peterotte/HPCSlowControl/README.md

# HPCSlowControl
HPC SlowControl for Arduino

This is an sample implementation for the Sensor Aggregation Unit to read out connected OneWire and I2C sensors. 

Arduino Folder
  * Eagle Files (and converted into PDF)
  * Schematics housing as PDF
  * Bootloader with settings fpr ATMEL Mega 328PB
