peterotte/HPCSlowControl/arduinofiles/HIM-Otte-server-slow-control-V1-3a-brd.pdf

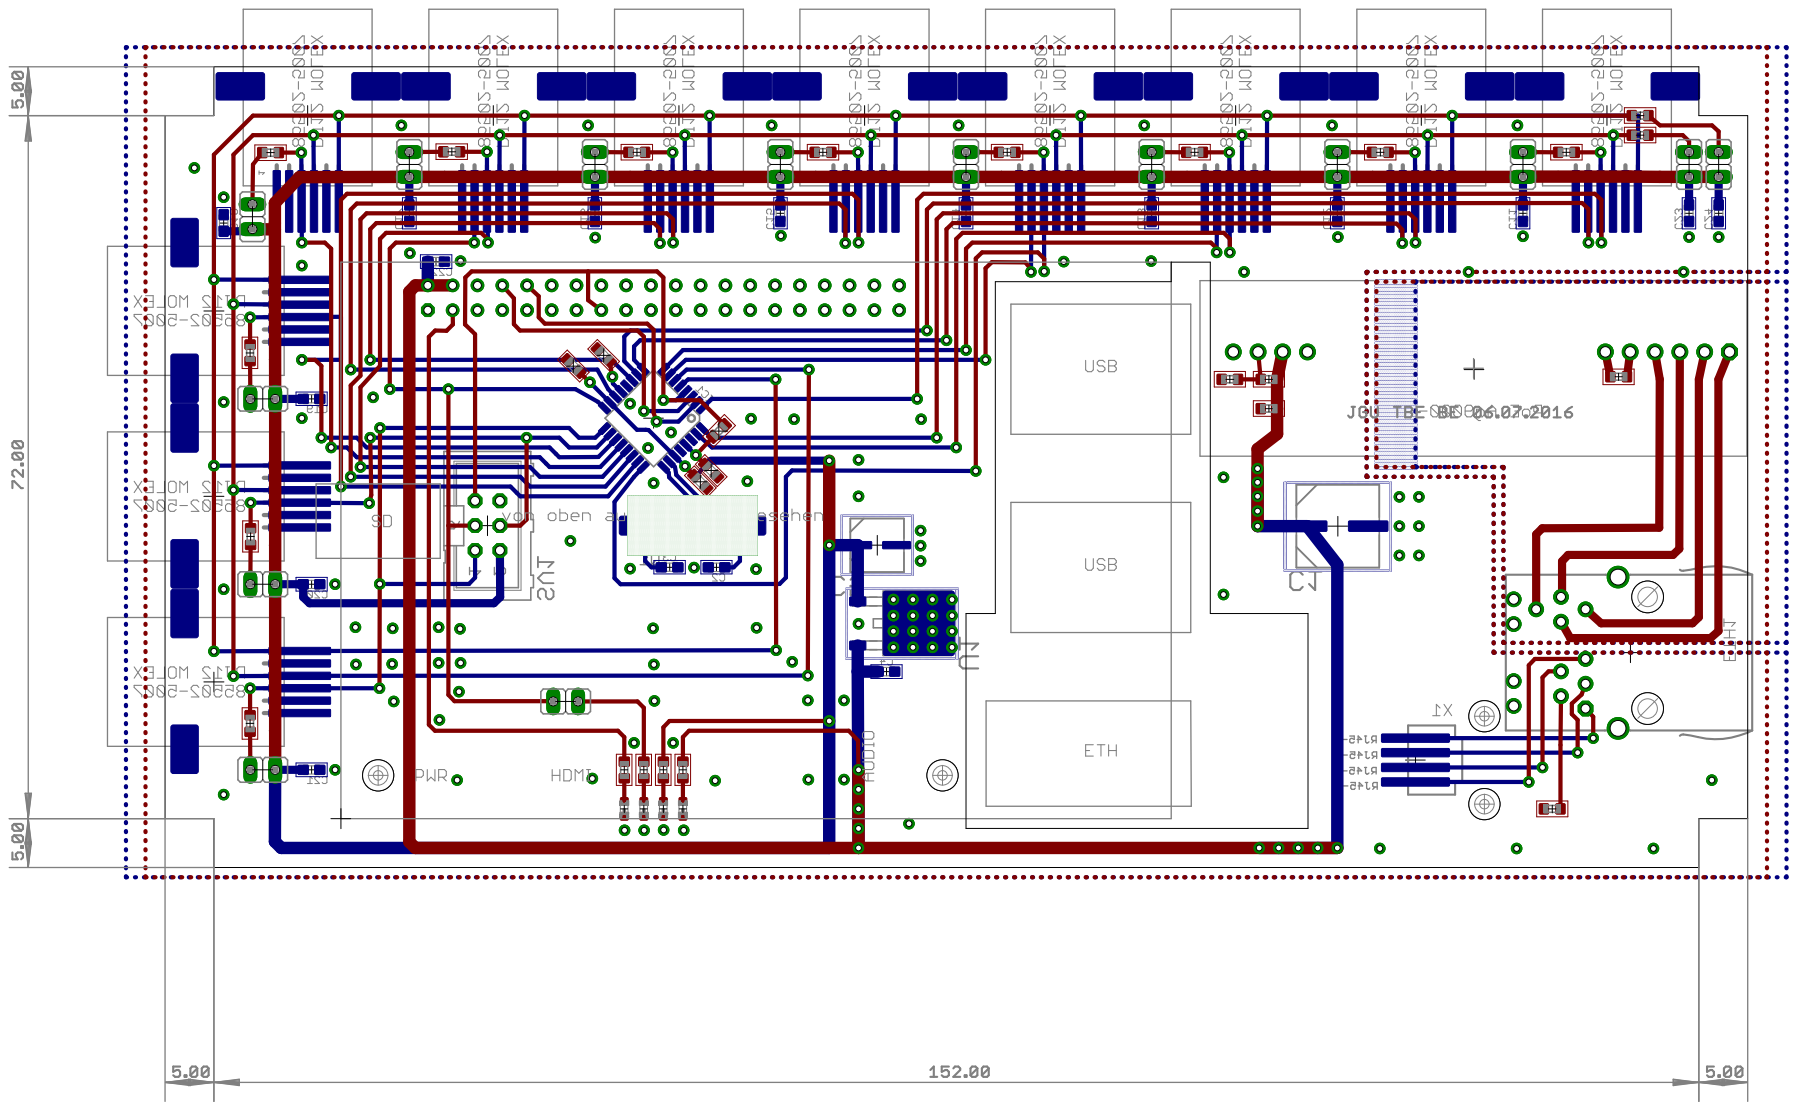
[picture p1: page 1]
