peterotte/HPCSlowControl/arduinofiles/HIM-Otte-server-slow-control-V1-3a-sch.pdf

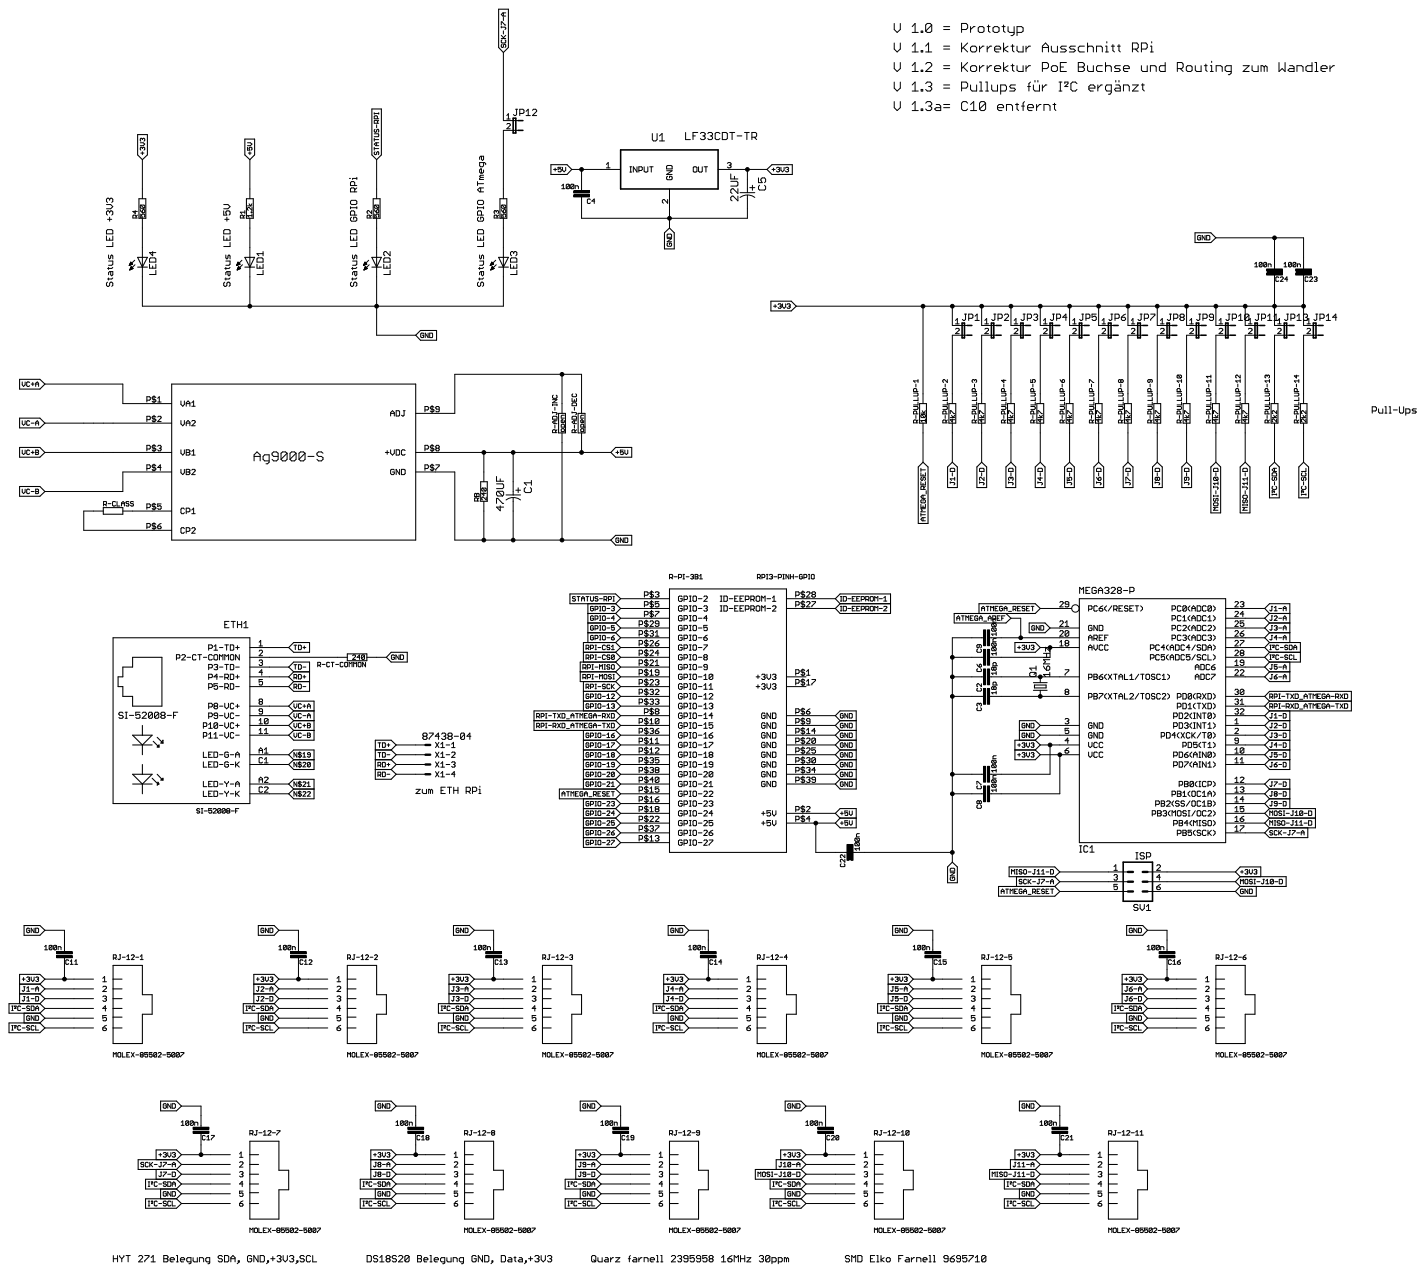
[picture p2: page 1]
