peterotte/HPCSlowControl/arduinofiles/HIM-Otte-server-slow-control-V1-2_Gehaeuse-lange-Seite.pdf

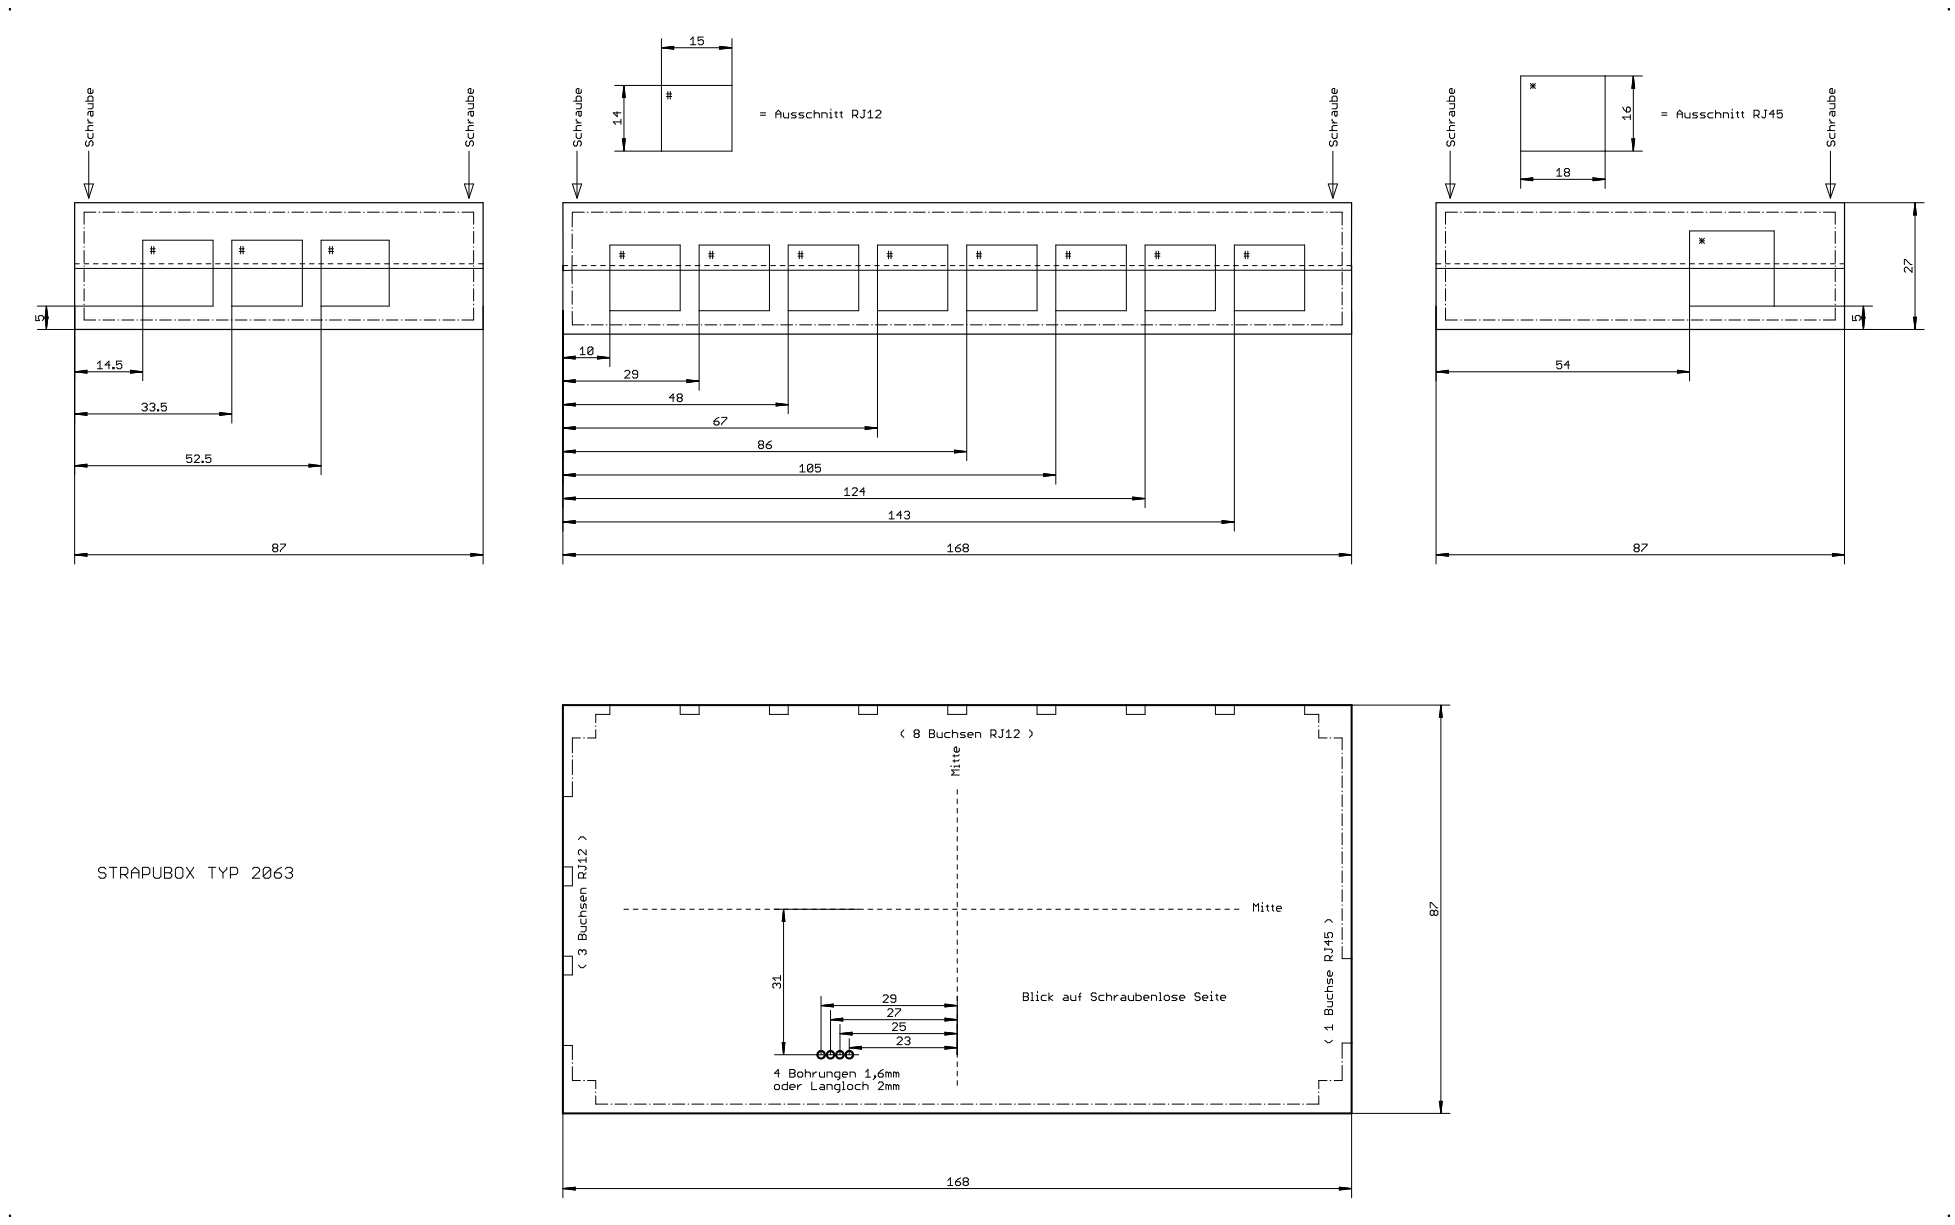
[picture p3: page 1]
