peterotte/HPCSlowControl/arduinofiles/HIM-Otte-server-slow-control-V1-3a.brd

## EAGLE design arduinofiles/HIM-Otte-server-slow-control-V1-3a.brd (2017-09-28)

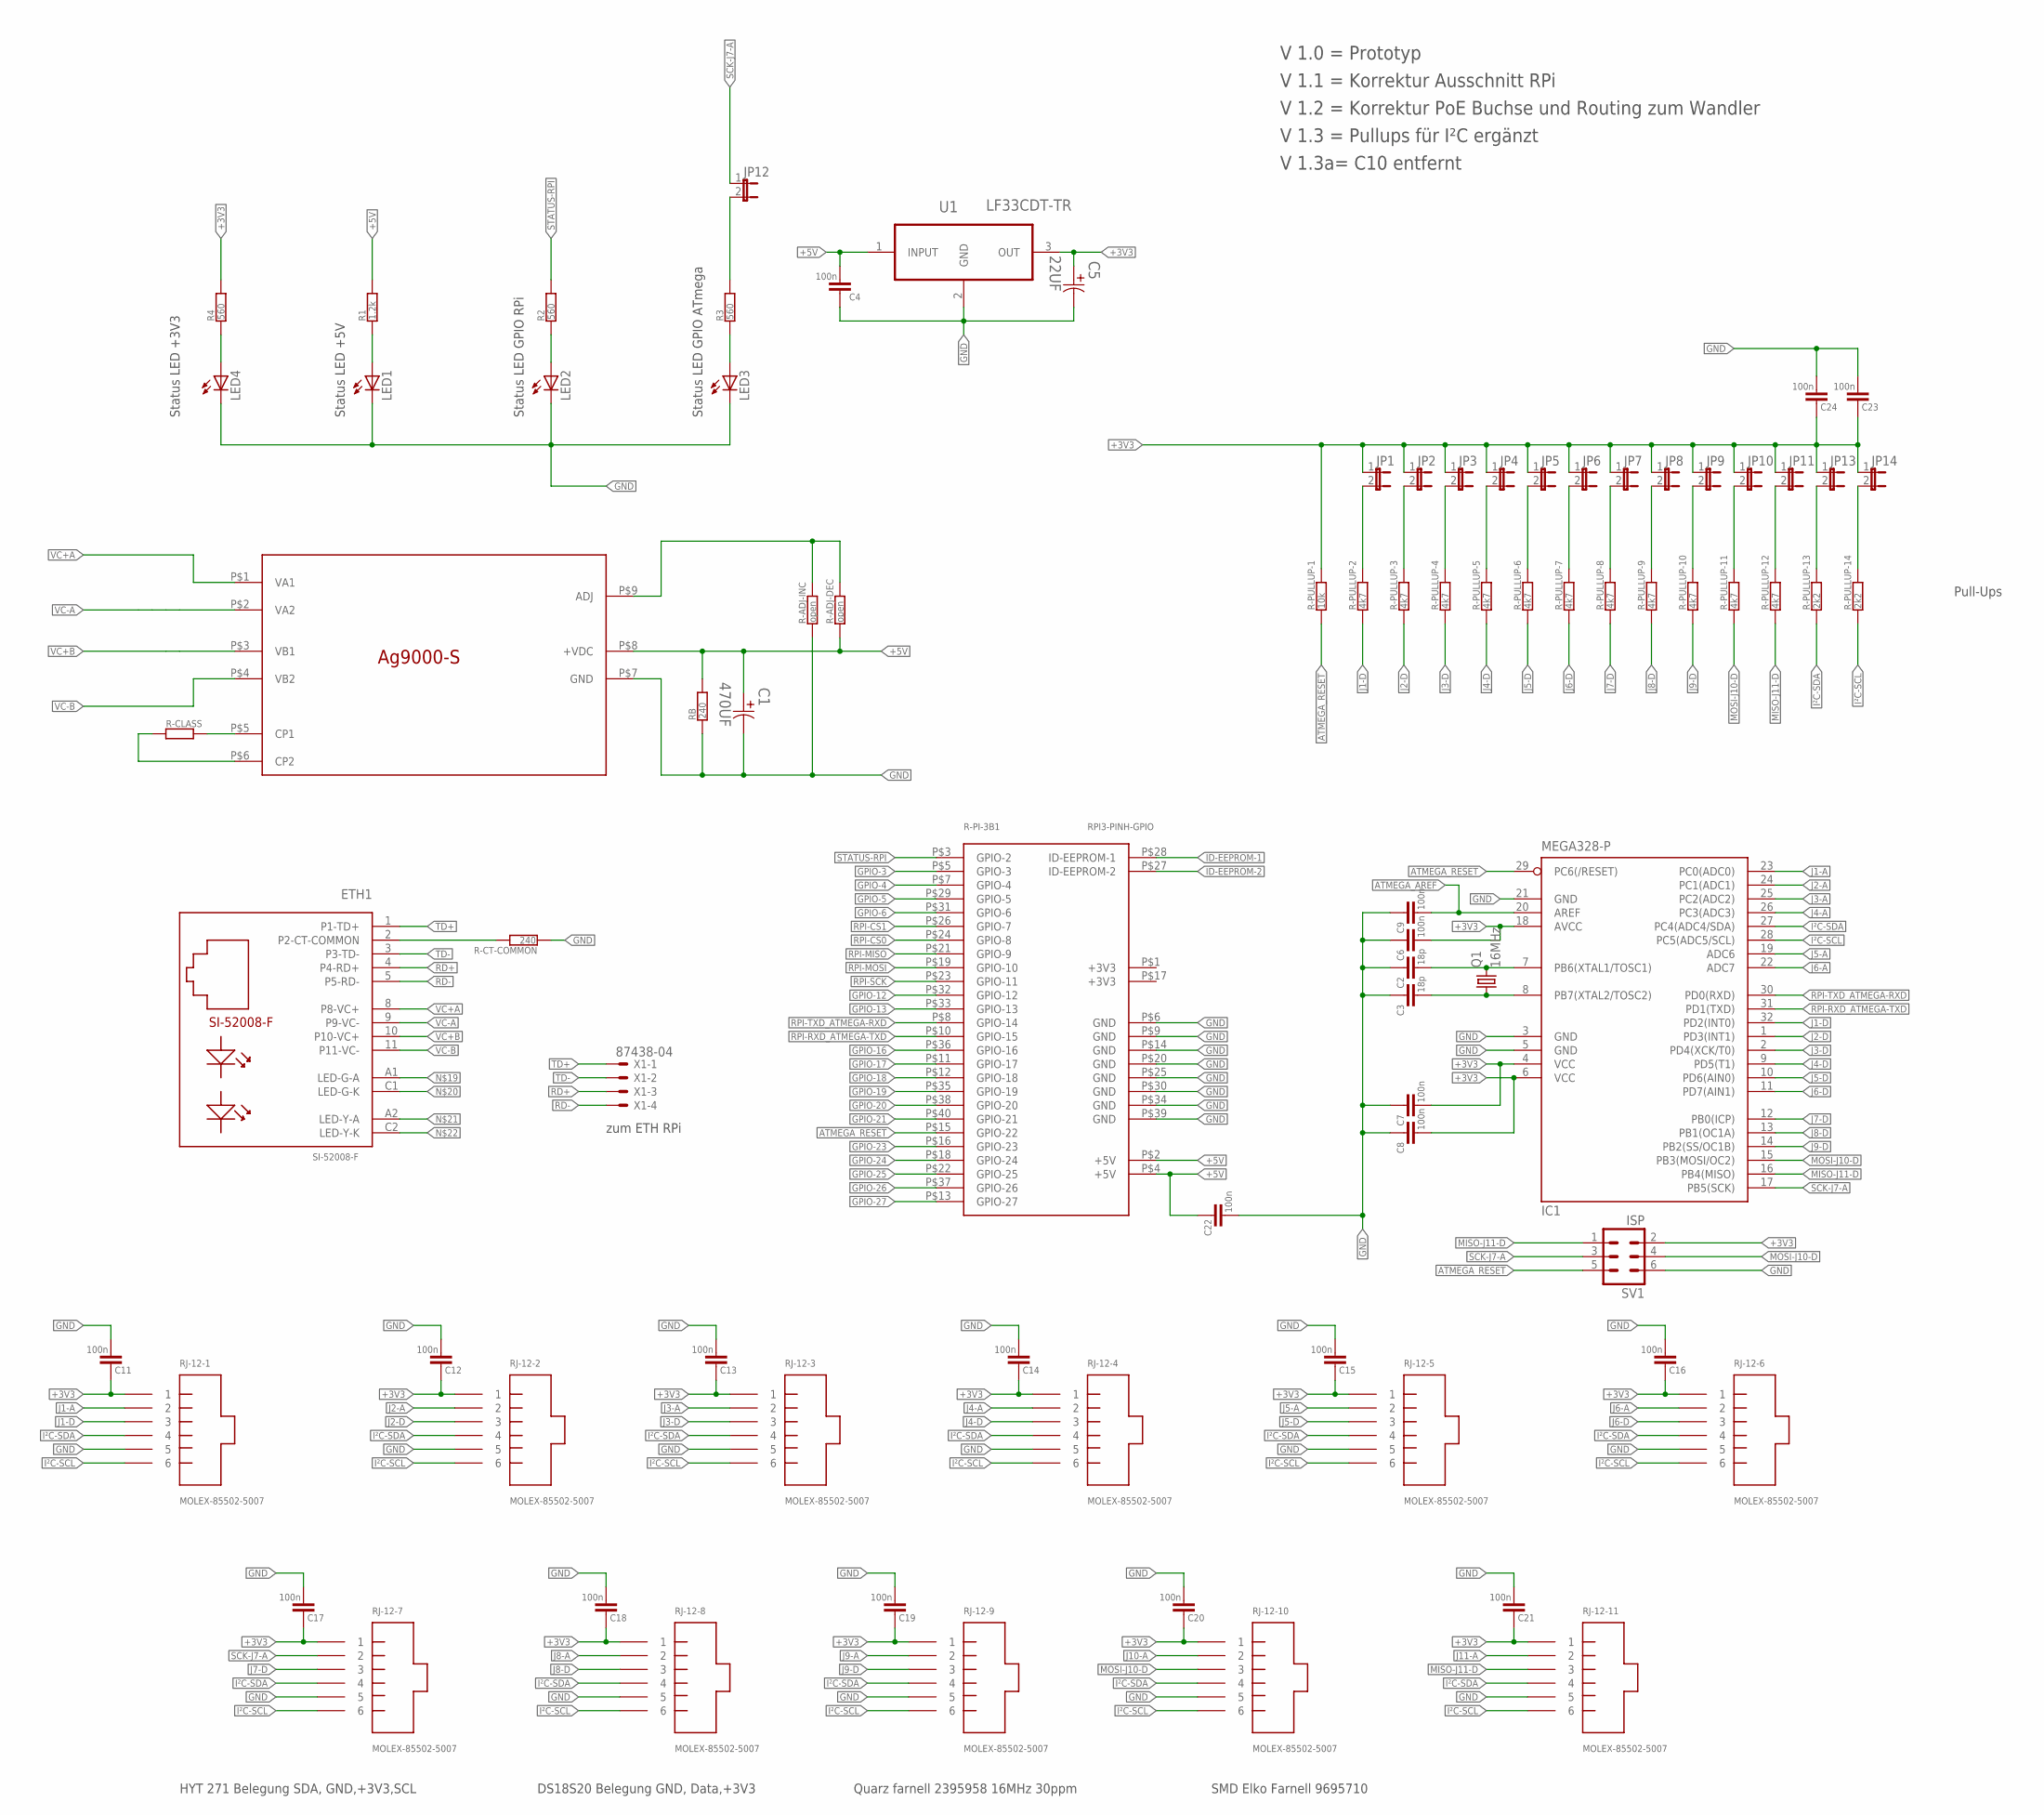
[picture p4: schematic HIM-Otte-server-slow-control-V1-3a.sch]

Parts:
C1: 470UF; CAPAE830X1050N
C2, C3: 18p; C0603
C4, C6, C7, C8, C9, C11, C12, C13, C14, C15, C16, C17, C18, C19, C20, C21, C22, C23, C24: 100n; C0603
C5: 22UF; CAPAE530X610N
ETH1: SI-52008-F
IC1: MEGA328-P; TQFP32-08
JP1, JP2, JP3, JP4, JP5, JP6, JP7, JP8, JP9, JP10, JP11, JP12, JP13, JP14: JP1E; JP1
LED1, LED2, LED3, LED4: LEDCHIPLED_0603; CHIPLED_0603
Q1: 16MHz; HC49UP
R1: 1.2k; R0603
R2, R3, R4: 560; R0603
R-ADJ-DEC: open; R0603
R-ADJ-INC: open; R0603
R-CLASS: R-EU_R0603; R0603
R-CT-COMMON: 240; R0603
R-PI-3B1: RPI3-PINH-GPIO
R-PULLUP-1: 10k; R0603
R-PULLUP-2, R-PULLUP-3, R-PULLUP-4, R-PULLUP-5, R-PULLUP-6, R-PULLUP-7, R-PULLUP-8, R-PULLUP-9, R-PULLUP-10, R-PULLUP-11, R-PULLUP-12: 4k7; R0603
R-PULLUP-13, R-PULLUP-14: 2k2; R0603
RB: 240; R0603
RJ-12-1, RJ-12-2, RJ-12-3, RJ-12-4, RJ-12-5, RJ-12-6, RJ-12-7, RJ-12-8, RJ-12-9, RJ-12-10, RJ-12-11: MOLEX-85502-5007
SV1: ISP; ML6
U1: LF33CDT-TR; TO228P972X240-3N
U$1: AG9000-S
X1: 87438-04

Connections:
+3V3: C5.1, C6.2, C7.2, C8.2, C11.1, C12.1, C13.1, C14.1, C15.1, C16.1, C17.1, C18.1, C19.1, C20.1, C21.1, C23.1, C24.1, IC1.4 (VCC), IC1.6 (VCC), IC1.18 (AVCC), JP1.1, JP2.1, JP3.1, JP4.1, JP5.1, JP6.1, JP7.1, JP8.1, JP9.1, JP10.1, JP11.1, JP13.1, JP14.1, R4.2, R-PULLUP-1.2, RJ-12-1.1, RJ-12-2.1, RJ-12-3.1, RJ-12-4.1, RJ-12-5.1, RJ-12-6.1, RJ-12-7.1, RJ-12-8.1, RJ-12-9.1, RJ-12-10.1, RJ-12-11.1, SV1.2, U1.3 (OUT)
+5V: C1.1, C4.2, C22.1, R1.2, R-ADJ-DEC.1, R-PI-3B1.P$2 (+5V), R-PI-3B1.P$4 (+5V), RB.2, U1.1 (INPUT), U$1.P$8 (+VDC)
ATMEGA_AREF: C9.2, IC1.20 (AREF)
ATMEGA_RESET: IC1.29 (PC6(/RESET)), R-PI-3B1.P$15 (GPIO-22), R-PULLUP-1.1, SV1.5
GND: C1.2, C2.1, C3.1, C4.1, C5.2, C6.1, C7.1, C8.1, C9.1, C11.2, C12.2, C13.2, C14.2, C15.2, C16.2, C17.2, C18.2, C19.2, C20.2, C21.2, C22.2, C23.2, C24.2, IC1.3 (GND), IC1.5 (GND), IC1.21 (GND), LED1.C, LED2.C, LED3.C, LED4.C, R-ADJ-INC.1, R-CT-COMMON.1, R-PI-3B1.P$6 (GND), R-PI-3B1.P$9 (GND), R-PI-3B1.P$14 (GND), R-PI-3B1.P$20 (GND), R-PI-3B1.P$25 (GND), R-PI-3B1.P$30 (GND), R-PI-3B1.P$34 (GND), R-PI-3B1.P$39 (GND), RB.1, RJ-12-1.5, RJ-12-2.5, RJ-12-3.5, RJ-12-4.5, RJ-12-5.5, RJ-12-6.5, RJ-12-7.5, RJ-12-8.5, RJ-12-9.5, RJ-12-10.5, RJ-12-11.5, SV1.6, U1.2 (GND), U$1.P$7 (GND)
GPIO-3: R-PI-3B1.P$5 (GPIO-3)
GPIO-4: R-PI-3B1.P$7 (GPIO-4)
GPIO-5: R-PI-3B1.P$29 (GPIO-5)
GPIO-6: R-PI-3B1.P$31 (GPIO-6)
GPIO-12: R-PI-3B1.P$32 (GPIO-12)
GPIO-13: R-PI-3B1.P$33 (GPIO-13)
GPIO-16: R-PI-3B1.P$36 (GPIO-16)
GPIO-17: R-PI-3B1.P$11 (GPIO-17)
GPIO-18: R-PI-3B1.P$12 (GPIO-18)
GPIO-19: R-PI-3B1.P$35 (GPIO-19)
GPIO-20: R-PI-3B1.P$38 (GPIO-20)
GPIO-21: R-PI-3B1.P$40 (GPIO-21)
GPIO-23: R-PI-3B1.P$16 (GPIO-23)
GPIO-24: R-PI-3B1.P$18 (GPIO-24)
GPIO-25: R-PI-3B1.P$22 (GPIO-25)
GPIO-26: R-PI-3B1.P$37 (GPIO-26)
GPIO-27: R-PI-3B1.P$13 (GPIO-27)
ID-EEPROM-1: R-PI-3B1.P$28 (ID-EEPROM-1)
ID-EEPROM-2: R-PI-3B1.P$27 (ID-EEPROM-2)
I²C-SCL: IC1.28 (PC5(ADC5/SCL)), R-PULLUP-14.1, RJ-12-1.6, RJ-12-2.6, RJ-12-3.6, RJ-12-4.6, RJ-12-5.6, RJ-12-6.6, RJ-12-7.6, RJ-12-8.6, RJ-12-9.6, RJ-12-10.6, RJ-12-11.6
I²C-SDA: IC1.27 (PC4(ADC4/SDA)), R-PULLUP-13.1, RJ-12-1.4, RJ-12-2.4, RJ-12-3.4, RJ-12-4.4, RJ-12-5.4, RJ-12-6.4, RJ-12-7.4, RJ-12-8.4, RJ-12-9.4, RJ-12-10.4, RJ-12-11.4
J1-A: IC1.23 (PC0(ADC0)), RJ-12-1.2
J1-D: IC1.32 (PD2(INT0)), R-PULLUP-2.1, RJ-12-1.3
J2-A: IC1.24 (PC1(ADC1)), RJ-12-2.2
J2-D: IC1.1 (PD3(INT1)), R-PULLUP-3.1, RJ-12-2.3
J3-A: IC1.25 (PC2(ADC2)), RJ-12-3.2
J3-D: IC1.2 (PD4(XCK/T0)), R-PULLUP-4.1, RJ-12-3.3
J4-A: IC1.26 (PC3(ADC3)), RJ-12-4.2
J4-D: IC1.9 (PD5(T1)), R-PULLUP-5.1, RJ-12-4.3
J5-A: IC1.19 (ADC6), RJ-12-5.2
J5-D: IC1.10 (PD6(AIN0)), R-PULLUP-6.1, RJ-12-5.3
J6-A: IC1.22 (ADC7), RJ-12-6.2
J6-D: IC1.11 (PD7(AIN1)), R-PULLUP-7.1, RJ-12-6.3
J7-D: IC1.12 (PB0(ICP)), R-PULLUP-8.1, RJ-12-7.3
J8-A: RJ-12-8.2
J8-D: IC1.13 (PB1(OC1A)), R-PULLUP-9.1, RJ-12-8.3
J9-A: RJ-12-9.2
J9-D: IC1.14 (PB2(SS/OC1B)), R-PULLUP-10.1, RJ-12-9.3
J10-A: RJ-12-10.2
J11-A: RJ-12-11.2
MISO-J11-D: IC1.16 (PB4(MISO)), R-PULLUP-12.1, RJ-12-11.3, SV1.1
MOSI-J10-D: IC1.15 (PB3(MOSI/OC2)), R-PULLUP-11.1, RJ-12-10.3, SV1.4
unnamed: JP11.2, R-PULLUP-12.2
unnamed: JP10.2, R-PULLUP-11.2
unnamed: JP9.2, R-PULLUP-10.2
unnamed: JP8.2, R-PULLUP-9.2
unnamed: R-CLASS.2, U$1.P$5 (CP1)
unnamed: R-CLASS.1, U$1.P$6 (CP2)
unnamed: R-ADJ-DEC.2, R-ADJ-INC.2, U$1.P$9 (ADJ)
unnamed: C2.2, IC1.7 (PB6(XTAL1/TOSC1)), Q1.2
unnamed: C3.2, IC1.8 (PB7(XTAL2/TOSC2)), Q1.1
unnamed: JP7.2, R-PULLUP-8.2
unnamed: ETH1.2 (P2-CT-COMMON), R-CT-COMMON.2
unnamed: JP6.2, R-PULLUP-7.2
unnamed: JP5.2, R-PULLUP-6.2
unnamed: JP4.2, R-PULLUP-5.2
unnamed: JP3.2, R-PULLUP-4.2
unnamed: JP2.2, R-PULLUP-3.2
unnamed: JP1.2, R-PULLUP-2.2
unnamed: LED4.A, R4.1
unnamed: JP12.2, R3.2
unnamed: JP13.2, R-PULLUP-13.2
unnamed: JP14.2, R-PULLUP-14.2
unnamed: LED1.A, R1.1
unnamed: LED2.A, R2.1
unnamed: LED3.A, R3.1
RD+: ETH1.4 (P4-RD+), X1.3
RD-: ETH1.5 (P5-RD-), X1.4
RPI-CS0: R-PI-3B1.P$24 (GPIO-8)
RPI-CS1: R-PI-3B1.P$26 (GPIO-7)
RPI-MISO: R-PI-3B1.P$21 (GPIO-9)
RPI-MOSI: R-PI-3B1.P$19 (GPIO-10)
RPI-RXD_ATMEGA-TXD: IC1.31 (PD1(TXD)), R-PI-3B1.P$10 (GPIO-15)
RPI-SCK: R-PI-3B1.P$23 (GPIO-11)
RPI-TXD_ATMEGA-RXD: IC1.30 (PD0(RXD)), R-PI-3B1.P$8 (GPIO-14)
SCK-J7-A: IC1.17 (PB5(SCK)), JP12.1, RJ-12-7.2, SV1.3
STATUS-RPI: R2.2, R-PI-3B1.P$3 (GPIO-2)
TD+: ETH1.1 (P1-TD+), X1.1
TD-: ETH1.3 (P3-TD-), X1.2
VC+A: ETH1.8 (P8-VC+), U$1.P$1 (VA1)
VC+B: ETH1.10 (P10-VC+), U$1.P$3 (VB1)
VC-A: ETH1.9 (P9-VC-), U$1.P$2 (VA2)
VC-B: ETH1.11 (P11-VC-), U$1.P$4 (VB2)

Notes on the sheet:
Status LED +5V
Status LED GPIO RPi
Status LED GPIO ATmega
HYT 271 Belegung SDA, GND,+3V3,SCL
DS18S20 Belegung GND, Data,+3V3
SMD Elko Farnell 9695710
Quarz farnell 2395958 16MHz 30ppm
zum ETH RPi
Pull-Ups
Status LED +3V3
V 1.0 = Prototyp
V 1.1 = Korrektur Ausschnitt RPi
V 1.2 = Korrektur PoE Buchse und Routing zum Wandler
V 1.3 = Pullups für I²C ergänzt
V 1.3a= C10 entfernt

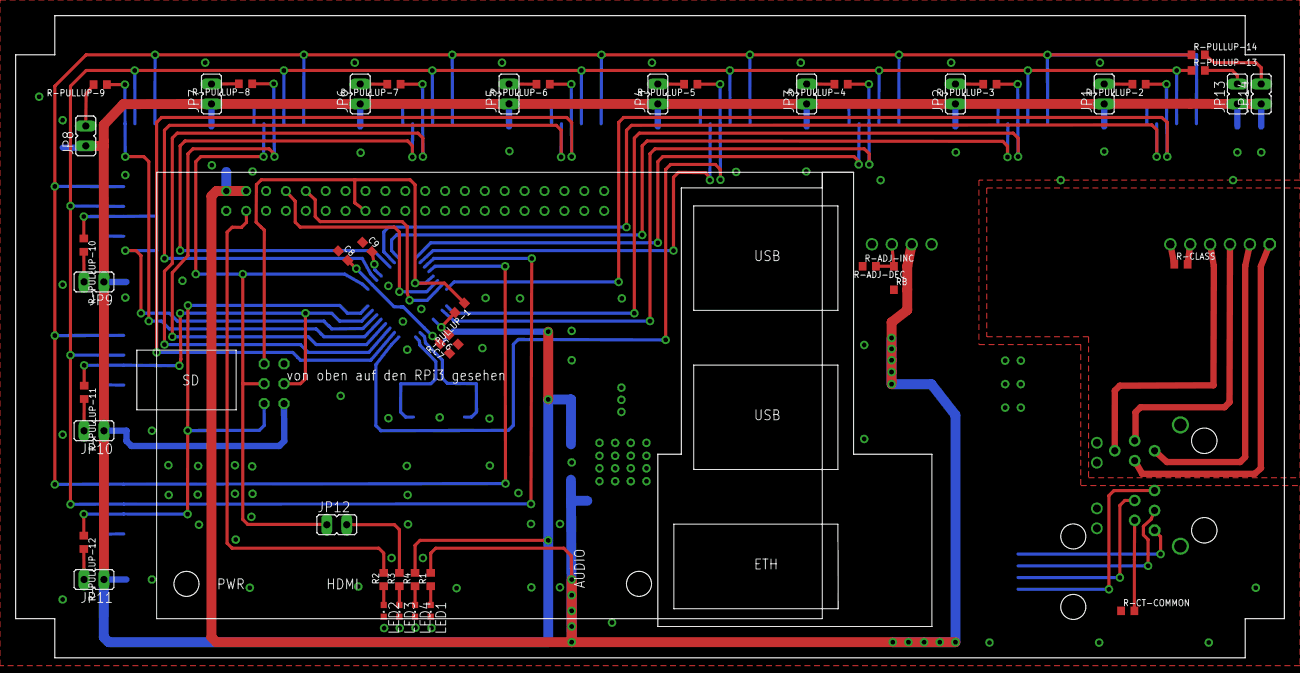
[picture p5: board HIM-Otte-server-slow-control-V1-3a.brd from above]

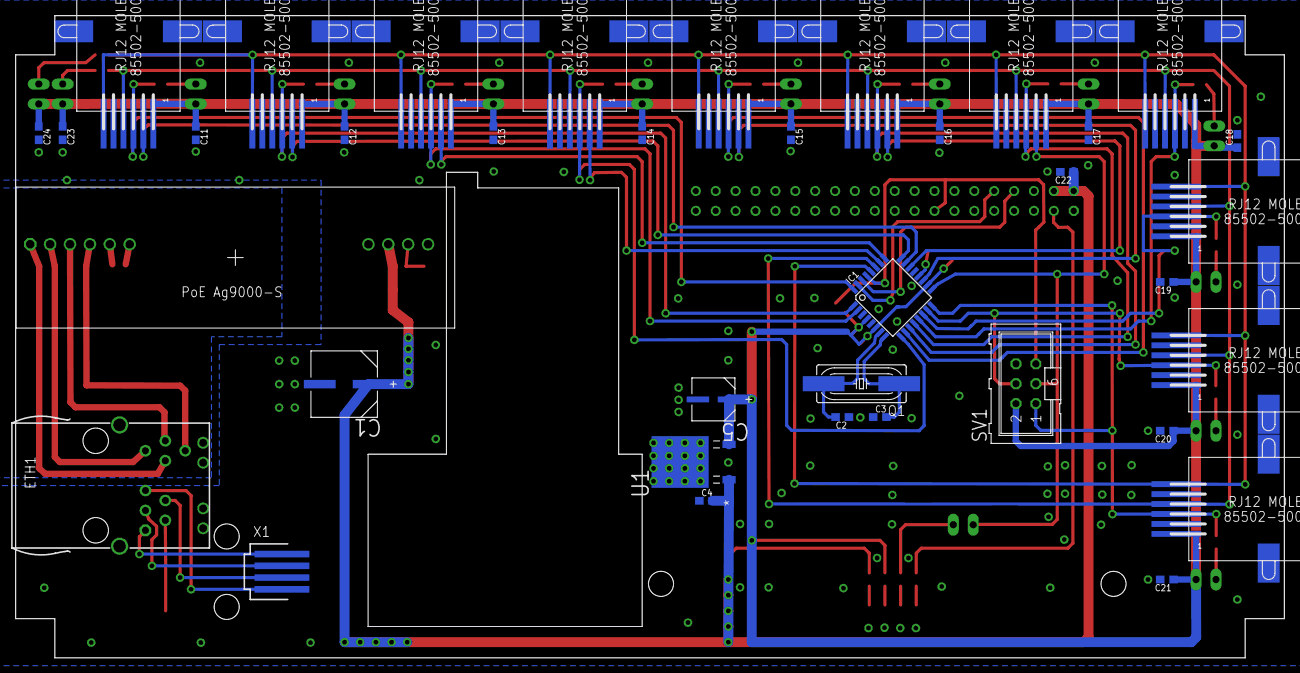
[picture p6: board HIM-Otte-server-slow-control-V1-3a.brd from below]

Board: 2 copper layers, 162.0 x 82.0 mm, 83 parts (37 on the bottom side), 60 nets.
