peterotte/HPCSlowControl/(commit log)

2017-09-26 Arduino files added
    Schematics, derber files, and details for flashing added.
    [HIM-Otte-server-slow-control-V1-3.brd, HIM-Otte-server-slow-control-V1-3.sch]
2017-09-28 C10 removed
    All affected files have been updated.
    [HIM-Otte-server-slow-control-V1-3a.brd, HIM-Otte-server-slow-control-V1-3a.sch]
